moriyasujapan/mz32-fan-control/esp32/board.png

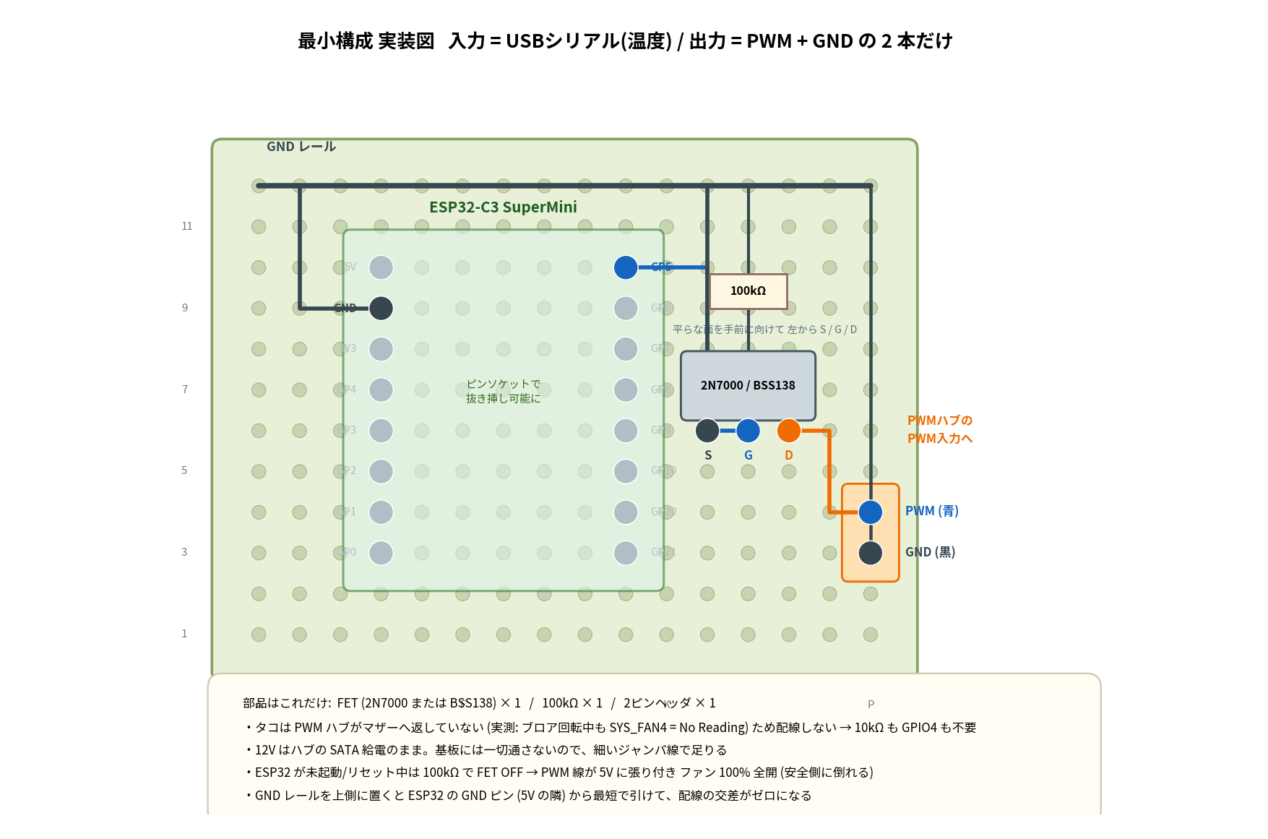
esp32/board.png
