moriyasujapan/mz32-fan-control/esp32/case_tnf2944_base.png

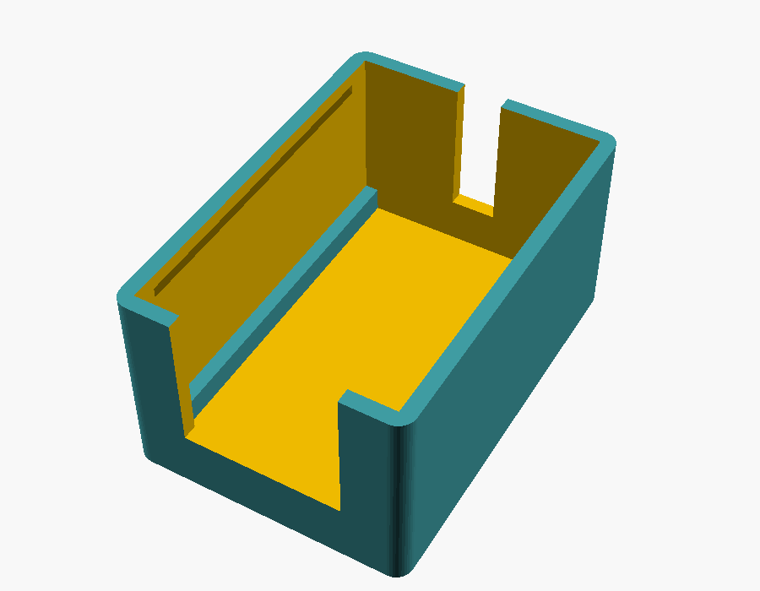
esp32/case_tnf2944_base.png
