moriyasujapan/mz32-fan-control/report.png

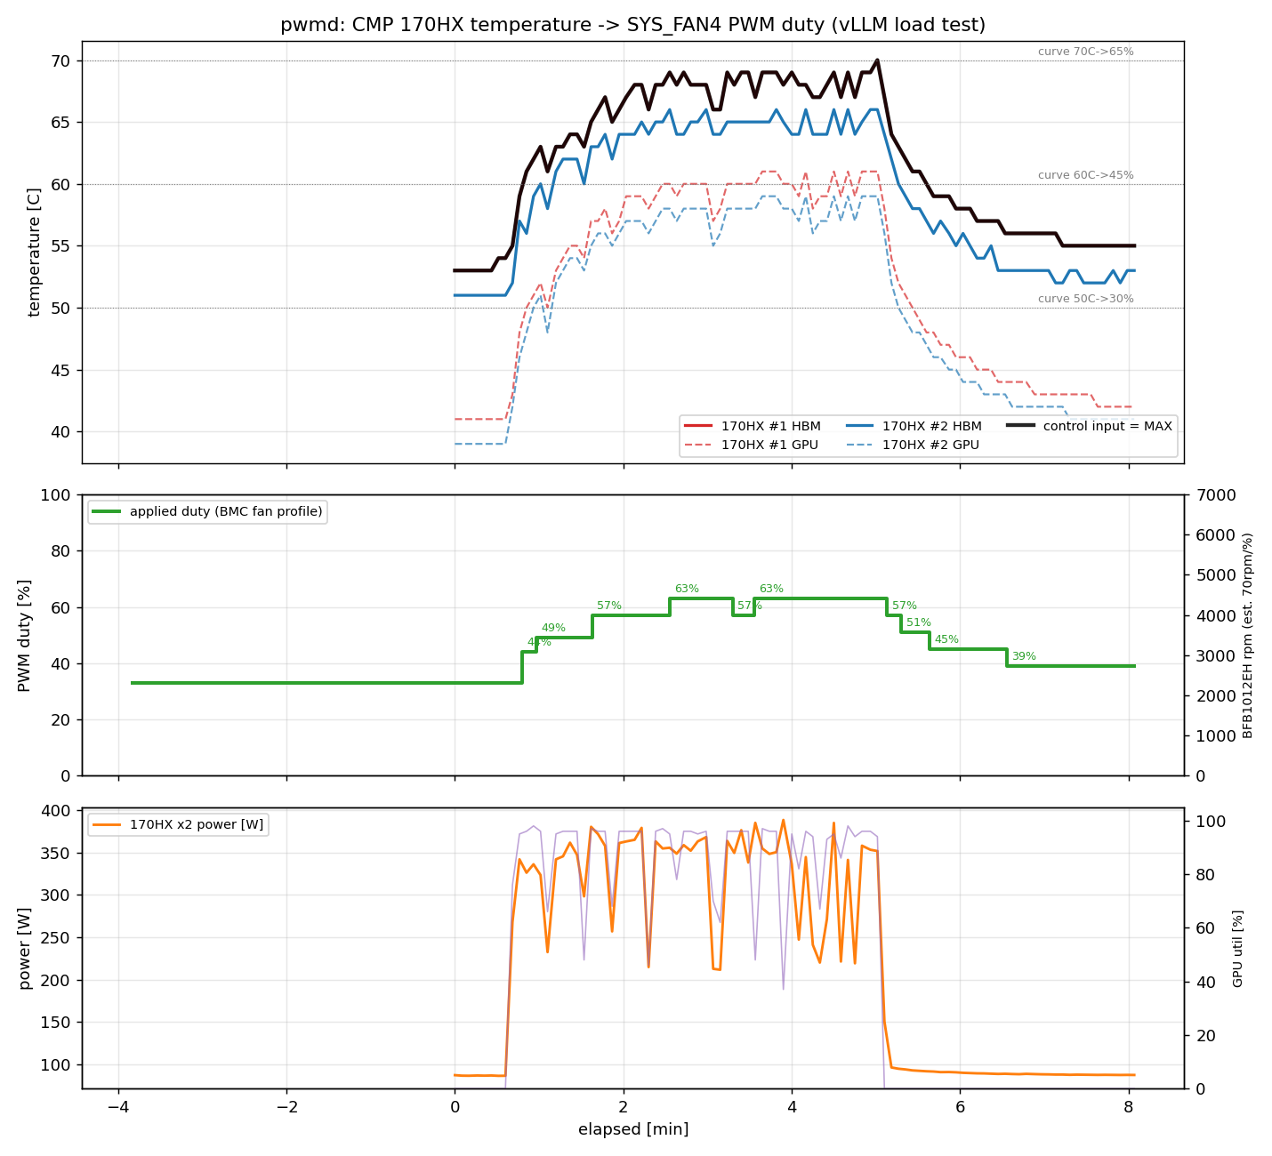
report.png
