moriyasujapan/mz32-fan-control/esp32/BOM.md

# M5Stamp-C3 ブロアファンコントローラ 部品表・配線表

対象ファン: **BitWindow BFB1012EH** (12V / 2.94A ≒ 35W / 7000rpm / 4PIN PWM)
マイコン: **M5Stack Stamp-C3 (SKU: C056-B)** — ESP32-C3 / 4MB Flash / USB-C (CH9102 経由) / 5V→3.3V DC-DC 内蔵
配線図: [wiring.png](wiring.png) ([wiring.svg](wiring.svg) が原本) / 実装図: [assembly_guide.png](assembly_guide.png)

## 0. SuperMini 版からの変更点

| 項目 | SuperMini 版 | Stamp-C3 版 |
|---|---|---|
| USB | native USB-CDC (GPIO18/19) | **CH9102 USB-UART ブリッジ** (UART0 = GPIO20/21) |
| Arduino 設定 | USB CDC On Boot: **Enabled** | USB CDC On Boot: **Disabled** (`Serial` は UART0 → CH9102) |
| 状態表示 LED | GPIO8 単色 LED | **GPIO2 SK6812 (RGB)** |
| ユーザーボタン | なし | **GPIO3** (外部ピン非露出) |
| 外部 IO | 0,1,3,4,5,6,7,10 他 | **G0,1,4,5,6,7,8,9,10,18,19,20,21** の 13 本 |
| 技適 | 無し (要 XIAO 等) | 取得済み |
| 実装 | 2×8 ピンソケット | 2.54mm ピッチ端子 (ピンヘッダを自分ではんだ付け) |
| PWM ピン | GPIO5 | **GPIO5 (変更なし)** |

## 0. 対応ボード

| ボード | PWM ピン | USB CDC On Boot | Arduino core | 状態LED | 技適 |
|---|---|---|---|---|---|
| **M5Stamp-C3** | **G5** (GPIO5) | **Disabled** (CH9102 → UART0) | 2.x / 3.x | SK6812 (G2) 青=boot/緑=host/赤=failsafe | あり |
| **XIAO ESP32C6** | **D1** (GPIO1) | **Enabled** (native USB Serial/JTAG) | **3.0.0 以降が必須** | 単色LED (GPIO15) 点灯=全開中 | 本体の刻印で要確認 |

ファームは `ARDUINO_XIAO_ESP32C6` の定義有無で自動的に切り替わる (v1.3.0〜)。
`V` コマンドの応答に `board=` が付くので、焼いたファームがどちらの設定か確認できる。

### XIAO ESP32C6 でピンを選ぶときの注意

ESP32-C6 のストラッピングピンは **GPIO4 / 5 / 8 / 9 / 15**。Stamp-C3 で使っていた
**GPIO5 は C6 では使用不可** (JTAG MTDI 兼ストラッピング、しかもヘッダに出ていない)。

XIAO C6 のヘッダは以下で、**いずれもストラッピングではない**ので自由に選べる:

| XIAO | D0 | D1 | D2 | D3 | D4 | D5 | D6 | D7 | D8 | D9 | D10 |
|---|---|---|---|---|---|---|---|---|---|---|---|
| GPIO | 0 | **1** | 2 | 21 | 22 | 23 | 16 | 17 | 19 | 20 | 18 |
| 備考 | ADC | **PWM 出力に使用** | ADC | | SDA | SCL | TX | RX | SCK | MISO | MOSI |

D0 (GPIO0) は将来サーミスタを足すとき用の ADC として空けてある。
D6/D7 は UART なので避ける。GPIO3 (RF スイッチ電源) と GPIO14 (アンテナ切替) は
ヘッダに出ていないが、外部アンテナを使う場合のみ触る。

出典: [Seeed Studio XIAO ESP32C6 Wiki](https://wiki.seeedstudio.com/xiao_esp32c6_getting_started/)

## 1. 部品表 (必須)

| # | 部品 | 型番・仕様 | 数量 | 価格目安 | 入手先 |
|---|---|---|---|---|---|
| 1 | マイコンボード | **M5Stack Stamp-C3 (C056-B)** または **Seeed XIAO ESP32C6** | 1 (予備込み2) | 1,000〜1,500円 | スイッチサイエンス / 秋月 / M5Stack公式 |
| 2 | Nch MOSFET | **2N7000** (TO-92) | 1 | 20円 | 秋月・共立 |
| 3 | 抵抗 | **100kΩ** 1/4W (ゲートプルダウン) | 1 | 5円 | 共立 6AZ312 |
| 4 | スズメッキ線 | **0.65mm** (裏面配線用・約15cm) | 1 | 手持ち | 秋月・共立 |
| 5 | 出力端子 | 2.54mm 2P ピンヘッダ (または 0.65mm 線を立てて端子に) | 1 | 10円 | 秋月・共立 |
| 6 | ケース兼基板 | PETG 印刷 (`stampc3_base` / `stampc3_lid` / `stampc3_bottom`) | 1式 | 材料費 約30円 | Bambu Lab A1 mini |
| 7 | 4PIN分岐ケーブル | 手持ちの PWM ハブ用分岐ケーブルを流用 | - | 0円 | - |
| 8 | USB ケーブル | USB-A ⇔ USB-C (データ通信対応) | 1 | 手持ち | - |

**合計 約1,100〜1,600円** (Stamp-C3 以外は 70 円程度)

ユニバーサル基板・変換基板・1kΩ ゲート抵抗は使わない。

## 3. MOSFET 選定の根拠

PWM 線のシンク電流は最大 5mA。2N7000 (Vgs(th) 最大 3V) を 3.3V で駆動するとオン抵抗は悪化するが、`5mA × 50Ω = 0.25V` で VIL(max) 0.8V に対し十分余裕がある。

## 4. 配線表

### Stamp-C3 側

| Stamp-C3 ピン | 接続先 | 備考 |
|---|---|---|
| **G5** (左列 3番) | FET ゲート (100kΩ で GND へプルダウン) | 25kHz PWM 出力 (LEDC) |
| GND (左列 1番) | FET ソース / 出力 GND / SATA の GND と共通 | **必須** |
| USB-C | ホストPCへ | 給電 + シリアル (CH9102)。入力は 5V のみ |
| 5V / 3V3 | 未接続 | 5V 端子と USB を同時に給電しない |

出力は **PWM と GND の 2 本のみ**。PWM ハブの「マザーへ挿す側の 4PIN オスプラグ」の **pin4 (PWM, 青)** と **pin1 (GND, 黒)** を使う。12V (pin2) と Tach (pin3) は触らない。

#### Stamp-C3 で使ってはいけないピン

| ピン | 理由 |
|---|---|
| **G20 / G21** | UART0 TX/RX。CH9102 に接続済みでシリアル通信に使用中 |
| **G8 / G9** | ストラッピングピン。G8 は書き込み時 High 必須 (プルダウン厳禁)、G9 は Low で書き込みモード |
| G2 | オンボード SK6812 (かつストラッピング)。外部非露出 |
| G3 | オンボードユーザーボタン。外部非露出 |
| G18 / G19 | native USB D-/D+。USB は CH9102 側なので GPIO として使えるが、起動直後に USB-JTAG 機能が有効なため PWM 用途には避ける |

→ 空いている **G0, G1, G4, G5, G6, G7, G10** から選ぶ。本設計では PWM=**G5**。

### ファン 4PIN コネクタ側

| Pin | 名称 | 線色 | 接続先 |
|---|---|---|---|
| 1 | GND | 黒 | SATA の GND (Stamp-C3 の GND と共通) |
| 2 | +12V | 赤 | SATA の +12V (黄) |
| 3 | Tach | 黄/緑 | **未接続** (PWM ハブがタコを返さないため) |
| 4 | PWM | 青 | FET ドレイン |

### FET (2N7000 / TO-92)

| 端子 | 接続先 |
|---|---|
| S (ソース) | GND |
| G (ゲート) | Stamp-C3 **G5** + 100kΩ → GND |
| D (ドレイン) | 出力 PWM → ハブ pin4 (青) |

## 4.5 ケース (PETG / Bambu Lab A1 mini)

> **重要 — 「ベース板が基板を兼ねる」方式は失敗した (2026-10-22 実機)**
>
> 当初は PETG のベース板に直接部品を挿し、裏面の溝に 0.65mm スズメッキ線を
> はめてはんだ付けする設計だった。**これは原理的に成立しない。**
>
> | | 温度 |
> |---|---|
> | PETG のガラス転移点 | **約 80℃** |
> | はんだごて | 300〜350℃ |
> | 共晶はんだの融点 | 183℃ |
>
> 部品のリードは金属なので、こて先の熱がそのまま穴の周囲へ伝わる。ランドの
> ない樹脂板では穴が広がって保持力を失う。印刷設定では解決せず、ABS/PC/ASA
> に変えても同じ (はんだ付け温度に耐える熱可塑性樹脂は実用範囲にない)。
> 基板が FR-4 (ガラスエポキシ、耐熱 130℃以上) である理由がこれ。
>
> また 0.65mm の裸スズメッキ線は熱容量が大きく、溝に置くだけでは固定もされず、
> 非常にはんだ付けしにくい。
>
> **対策: 回路はユニバーサル基板に組み、印刷物はケースとしてのみ使う。**
> 配線材は 0.65mm 裸線ではなく **ジュンフロン線 AWG30 (PTFE 被覆)** を推奨。
> こてが触れても被覆が縮まず、細くて取り回しが効き、交差させても短絡しない。
> 配線が 3 本しかないので、100kΩ の切り落とした足を流用するのも確実。

配線図: [assembly_guide.png](assembly_guide.png) (左: 下から見た裏面配線 / 右: 上から見た部品配置)
※ この図は破棄した「基板兼ケース」方式のもの。ユニバーサル基板版に引き直す必要がある。

| ファイル | 内容 | 印刷向き |
|---|---|---|
| `stampc3_base.stl` | 基板兼ベース (板厚 2mm + 下側スカート 4mm)。穴・裏面溝・刻印付き | 出力済みの向きのまま (板の上面がベッド側) |
| `stampc3_lid.stl` | 蓋。Stamp 上の窓、USB-C 開口、出力端子穴、ベースとのスナップ溝 | 出力済みの向きのまま (天面がベッド側) |
| `stampc3_bottom.stl` | 底蓋。Stamp 直下に LED 用の窓 | そのまま |

推奨設定: PETG / 0.4mm ノズル / 0.2mm レイヤー / 壁 3 周 / インフィル 25% / サポート不要。穴は 1.25mm (ヘッダ・出力) と 1.0mm (2N7000・抵抗)。きつい場合は 1.2mm ドリルで通す。

### 部品配置 (上から見た図)

- Stamp-C3: **付属ヘッダをピン下向き**ではんだ付けし、22 穴に挿す。USB-C は G0/G1 側の端で、蓋の開口に合わせる
- **状態 LED は下向き**。ベース板と底蓋の Stamp 直下を抜いてあり、下から見える
- 2N7000: Stamp 左列から 4 ピッチ左。**平らな面を外側 (Stamp と反対) に向け**、上から S / G / D
- 100kΩ: Stamp 左列から 2 ピッチ左に縦に寝かせる。リードの間隔は 10.16mm
- 出力 2P: 一番左。上が GND、下が PWM。ピンヘッダか、0.65mm 線を立てて端子にする

### 裏面配線 (0.65mm スズメッキ線を溝にはめる)

| 線 | 経路 | 
|---|---|
| GND | Stamp GND (左列1番) → 100kΩ 上端 → 2N7000 S → 出力 GND (一直線) |
| GATE | Stamp G5 (左列3番) → 下へ → 100kΩ 下端 → 上へ → 2N7000 G |
| PWM | 2N7000 D → 出力 PWM |

各経路と別ネットの穴とは最小 2.54mm 離してある。裏面には `G5 / GND / PWM / 2N7000 / USB` を下から見て読める向きで刻印してある。Stamp のその他 20 ピンは機械的固定のみで配線しない。ヘッダの突き出しは 1.5mm 程度に切る。

### 組み立て順

1. 2N7000 と 100kΩ を表から挿し、裏で足を溝に沿わせて仮止め
2. 0.65mm 線を 3 本切り、溝にはめて各穴ではんだ。余った足は切る
3. 出力 2P を挿してはんだ
4. ヘッダ付き Stamp-C3 を挿してはんだ (G5 と GND は線と一緒に、残りは固定用)
5. テスターで G5–GND 間が約 100kΩ、GND–PWM 間が開放であることを確認
6. ベースを下から蓋に押し込みスナップ。底蓋を押し込む

## 4.6 代替案: BSS138 レベル変換モジュール

単石 FET の代わりに [秋月 AE-LCNV4-MOSFET](https://akizukidenshi.com/catalog/g/g113837/)
(4ビット双方向ロジックレベル変換、BSS138、¥200、DIP12) を使える。DIP モジュール
なのでユニバーサル基板に素直に載り、**100kΩ が不要になる** (LV 側に 10kΩ
プルアップ内蔵、ゲートは内部で LV に接続)。

| モジュール | 接続先 |
|---|---|
| `LV` | Stamp **3V3** |
| `GND` | Stamp **GND** |
| `LV1` | Stamp **G5** |
| `HV1` | ハブ **pin4 (PWM 青)** |
| `HV` | **未接続** |

**`HV` を繋がないこと。** ファンが自前で 5V プルアップを持つので不要。Stamp の
5V を引くと、USB を抜いたときにモジュール側の 10kΩ が PWM 線を引き下げて分圧に
なる。未接続ならファンのプルアップが素直に勝って全開へ倒れる。

**外付けの 100kΩ プルダウンは付けない。** G5 がハイインピーダンス (起動中・
電源断) のとき、モジュール内蔵の LV プルアップが MOSFET を OFF にする。

### 論理が反転しなくなる

このモジュールは**非反転**なので、ファームの `PWM_INVERT` を `false` にして
書き込み直す必要がある。

| | 単石 FET | BSS138 モジュール |
|---|---|---|
| `PWM_INVERT` | `true` | **`false`** |
| G5 HIGH のとき PWM 線 | LOW | **HIGH** |
| 部品 | 2N7000 + 100kΩ | モジュールのみ |
| 配線 | 3 本 | 4 本 |

どちらの構成でも `duty=100` は「ファン全開」を意味し、boot / failsafe /
電源断のいずれでも全開に倒れる。`VER` 応答の `invert=` で現物がどちらで
ビルドされたか確認できる。

**PCA9306 (AE-PCA9306) は使わないこと。** I2C 専用のパスゲートで、1kΩ の強い
プルアップを内蔵している。VREF2 を Stamp の 5V から取ると、電源断時に PWM 線を
0.8V 程度まで引き下げてしまい、「電源断 = 全開」の安全性が逆転する。

## 5. 組み立て前に確認すること

1. **ファンの PWM プルアップ電圧をテスターで測る** (5V なら本設計どおり)。
2. **GND が共通になっているか**。Stamp-C3 をホストの USB から給電すればホスト PSU 経由で SATA の GND と共通になる。別の AC アダプタから給電しない。
3. **FET 無しで直結しない**。5V プルアップのファンに ESP32-C3 (絶対最大定格 3.6V) を直結すると破損する。
4. **USB ドライバ**: Linux は標準ドライバで `/dev/ttyACM0` (環境により `/dev/ttyUSB0`) として見える。macOS/Windows は CH9102 ドライバを導入。

## 6. ファームウェアの要点

SuperMini 版から変更するのは以下だけ。

- PWM: **LEDC 25kHz / 10bit**。`PWM_INVERT = true` なら `duty_out = 1023 - duty_target`、
  `false` なら `duty_out = duty_target` (出力段の方式に合わせる)
- `PIN_PWM = 5` (変更なし)
- 状態 LED を SK6812 (G2) に変更 (実装済み): arduino-esp32 v3 は `rgbLedWrite(2, r, g, b)`、
  v2 系は `neopixelWrite`。ファーム側で `ESP_ARDUINO_VERSION_MAJOR` を見て自動で切り替える
  - **boot=青 / host 制御=緑 / failsafe=赤**
- フェイルセーフ・シリアルプロトコルは変更なし (ファーム `1.1.0`)

### 書き込み手順 (Arduino IDE)

1. ボードマネージャで **esp32 by Espressif Systems** を入れる
2. ボード: **ESP32C3 Dev Module** (または M5Stack ボードパッケージの **M5StampC3**)
3. **USB CDC On Boot: Disabled** (Enabled にすると `Serial` が native USB に向き、CH9102 側に何も出ない)
4. 書き込みは CH9102 の DTR/RTS による自動リセットで入る。失敗する場合は G9 を GND に落としたままリセット
5. `screen /dev/ttyACM0 115200` などで `P` を送り `PONG pwmfan 1.2.0` が返れば成功

### ホスト側 (pwmd.py) の注意

CH9102 の DTR/RTS は ESP32-C3 の EN / G9 に繋がっているため、ポートを開くと**リセットが掛かる**。

**実測 (2026-10-22 / Ubuntu 26.04 + cdc_acm)**: `dtr=False` / `rts=False` を open 前に
セットしても、`stty -hupcl` を併用しても**リセットは防げない**。cdc_acm が open 時に
一度 DTR を上げるため。open のたびに `rst:0x1 (POWERON)` が起き、ROM ブートログが
9 行 (236 bytes) 流れてくる:

```
ESP-ROM:esp32c3-api1-20210207
rst:0x1 (POWERON),boot:0xc (SPI_FAST_FLASH_BOOT)
... entry 0x403cbf10
```

リセット自体は**安全側**なので許容する (boot = 100% 全開 / LED 青)。ただし
**ブートログを応答と取り違えると `set_duty` が失敗 → 再オープン → 再リセットの
ループに陥る**ため、ホスト側で読み捨てが必須。[`pwmd.py`](../pwmd.py) の
`SerialBackend` は `_drain()` でブートログを捨て、`OK / ST / PONG / VER / ERR`
で始まる行だけを応答として受け付ける (回帰テスト `[6]`)。

シェルから叩くときは、ディスクリプタを開きっぱなしにすれば追加のリセットは起きない:

```bash
sudo bash -c '
exec 3<>/dev/ttyACM0
stty -F /dev/ttyACM0 115200 raw -echo
timeout 1.5 cat <&3 >/dev/null     # ブートログを捨てる
echo "P" >&3; read -t 2 -r l <&3; echo "$l"
'
```

pyserial で開く場合はこの形 (DTR/RTS を落とすこと自体は他のアダプタで効くので残す):

```python
ser = serial.Serial()
ser.port = "/dev/ttyACM0"
ser.baudrate = 115200
ser.dtr = False
ser.rts = False
ser.open()
```

## 7. 現行 (BMC Web API) 版との関係

SuperMini 版と同じ。マザーボードの SYSFAN ヘッダーは使わず BMC から独立。Stamp-C3 が故障したら PWM 線を SYS_FAN4 に差し替えるだけで BMC 版へ戻せる。

## 7.5 組み立て時の落とし穴: 極性が反転する配線ミス (2026-10-22 実機で遭遇・解決済み)

**症状**: `D 20` でファンが高速、`D 100` でほぼ停止。つまり **ファン速度 = 100 - duty**。
FET によるオープンドレイン反転が効かず、G5 の信号がそのまま PWM 線に出ている。

**原因**: 出力 PWM を FET の**ドレインではない端子**から取っていた。TO-92 の
真ん中はゲートで、ここから取ると FET を素通りして G5 が直接ファンの PWM 線を
駆動する。ドレインとソースを逆に挿しても同様に正しく動かない。

**切り分け** (SYS_FAN4 を抜いて単独駆動にしてから行うこと。繋いだままだと
BMC のプッシュプル出力と競合し、音も温度も判定材料にならない):

| 試験 | 正しい配線なら | 反転しているなら |
|---|---|---|
| `D 100` | **全開** | ほぼ停止 |
| `D 20` | 静か | うるさい |
| デーモン停止 (30秒無通信 → failsafe) | **全開** | 静かなまま温度上昇 |

`D 50` はどちらの極性でも 50% になるので、切り分け中の暫定保持に使える。

**最も確実な判定**: デーモンを止めて全開になるかを聴く。これは同時に
「ホストが死んでも冷え続ける」という設計の核心を検証することにもなる。

**配線の正解** (ノードは 3 つだけ):

| ノード | 繋がるもの |
|---|---|
| ゲート | `G5` ＋ 100kΩ の片脚 ＋ FET の **G**（真ん中） |
| GND | `GND` ＋ 100kΩ のもう片脚 ＋ FET の **S** ＋ ハブ pin1 |
| PWM | FET の **D** ＋ ハブ pin4（青） |

GND はゲートに直結しない。100kΩ はゲートノードと GND ノードを橋渡しする部品で、
G5 が出力していない間ゲートを 0V に保つ (→ FET OFF → PWM 線 5V → 全開)。

**真の S / D をテスターで見分ける** (ダイオードモード。平らな面の向きに頼らない):

- 赤 **S** / 黒 **D** → 0.6〜0.7V（ボディダイオードが順方向）
- 赤 **D** / 黒 **S** → OL（開放）
- **G** はどちらに対しても OL

**放置してはいけない理由**: ゲート側から PWM を取っていると、G5 がファン内部の
5V プルアップに直結する。ESP32-C3 の絶対最大定格 3.6V を超え、クランプ
ダイオードに `(5 - 3.6) / 3.3k ≈ 0.4mA` が流れ続ける。正しくドレインから
取れば GPIO が 5V に触れることはない。

**応急処置** (配線を直すまでの繋ぎ): `config.ini` に `[serial] invert = true`。
ホスト側が `100-duty` を送る。ただしこれは**通常運転しか直せない**。ファームの
failsafe (duty=100) と電源断時の安全性は反転したままで、どちらも「全開」ではなく
「停止」を意味する状態が残る。必ず配線を直して `invert = false` に戻すこと。

## 8. ファームウェア

| ファイル | 内容 |
|---|---|
| [`pwmfan/pwmfan.ino`](pwmfan/pwmfan.ino) | Stamp-C3 用ファーム (Arduino) `1.2.0`。25kHz LEDC + `PWM_INVERT` + 30秒フェイルセーフ + 状態 LED |
| [`mock_pwmfan.py`](mock_pwmfan.py) | 同じプロトコルを pty 上で再現するモック。実機なしで検証するため |
| [`test_serial_backend.py`](test_serial_backend.py) | `pwmd.py` の serial バックエンド結合テスト (15項目) |

### シリアルプロトコル

| 送信 | 応答 | 意味 |
|---|---|---|
| `D <0-100>` | `OK D=<n>` | duty 設定 (このコマンドがフェイルセーフのタイマもリセットする) |
| `S` | `ST duty=<n> src=<host\|failsafe\|boot> age=<ms>` | 状態取得 |
| `P` | `PONG pwmfan <ver>` | 疎通確認 |
| `V` | `VER pwmfan <ver> pin=<n> freq=<hz> invert=<0\|1>` | ビルド情報。`invert` で出力段の論理を確認できる |
| - | `EV failsafe timeout -> 100%` | 非同期通知 (ホスト沈黙時)。boot 中は出さない |

### 状態 LED (G2 / SK6812)

| 色 | 状態 | duty |
|---|---|---|
| 青 | boot — ホストとまだ一度も喋っていない | 100% |
| 緑 | host — ホストの指示どおり制御中 | 指示値 |
| 赤 | failsafe — ホストが 30 秒沈黙した | 100% |

### 検証結果 (モックファーム / 2026-10-22)

```
[1] 初期化      V/P 応答、起動直後は boot=100% (安全側)
[2] duty 指示   D 63 反映、S で確認、小数は四捨五入
[3] Controller  ヒステリシス内は据え置き + heartbeat は送出
[4] フェイルセーフ 無通信で 100%、再開で host 制御へ復帰
[5] 障害復旧    ポート切断後に自動再オープンして送信成功
[6] ブートログ  リセット直後の ROM ログを応答と誤読しない
→ 15 項目すべて PASS
```
