moriyasujapan/mz32-fan-control/esp32/case_tnf2944_base.stl

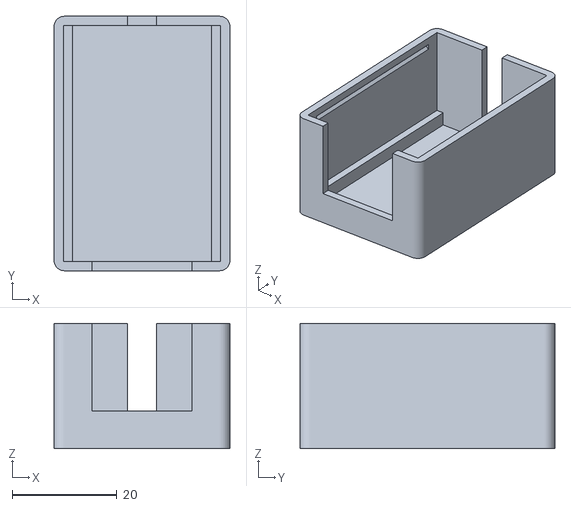
[picture p7: CAD file, 2026-10-25]
esp32/case_tnf2944_base.stl
33.6 x 48.6 x 23.9
