moriyasujapan/mz32-fan-control/esp32/case_tnf2944_lid.stl

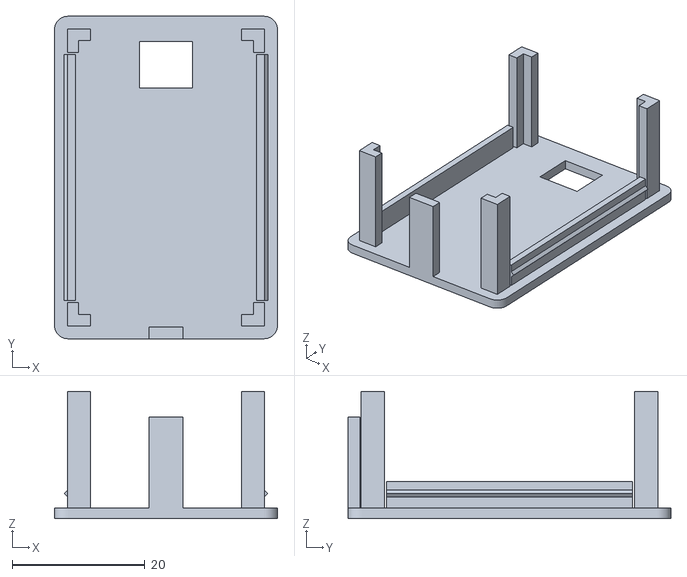
[picture p8: CAD file, 2026-10-25]
esp32/case_tnf2944_lid.stl
33.6 x 48.6 x 19.2
