moriyasujapan/mz32-fan-control/esp32/case_tnf2944.3mf

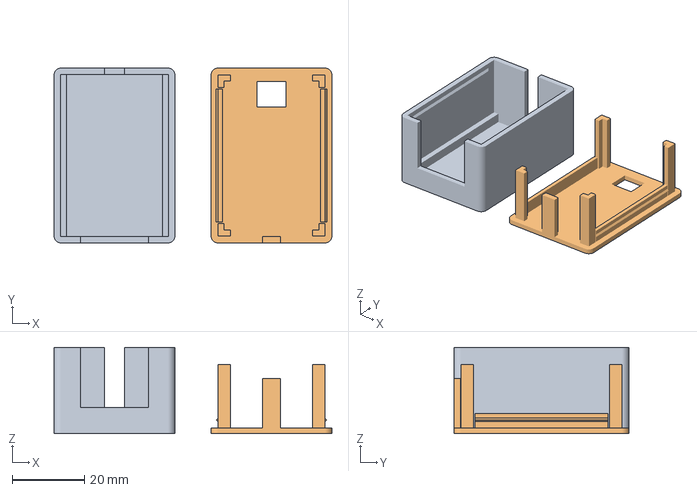
[picture p9: CAD file, 2026-10-25]
esp32/case_tnf2944.3mf
77.2 x 48.6 x 23.9 mm
case_tnf2944_base
case_tnf2944_lid
