moriyasujapan/mz32-fan-control/esp32/stampc3_lid.stl

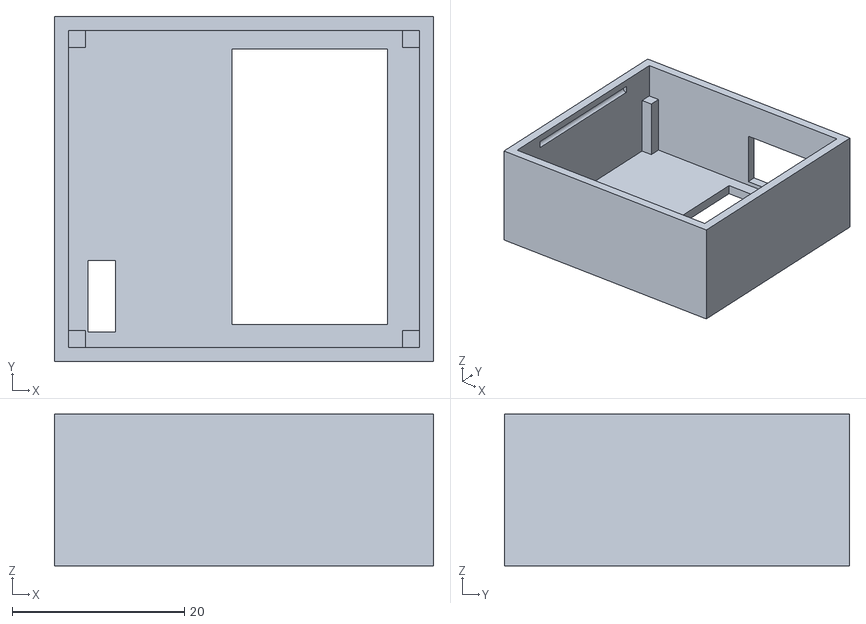
[picture p10: CAD file, 2026-10-21]
esp32/stampc3_lid.stl
44.0 x 40.0 x 17.6
