moriyasujapan/mz32-fan-control/esp32/stampc3_base.stl

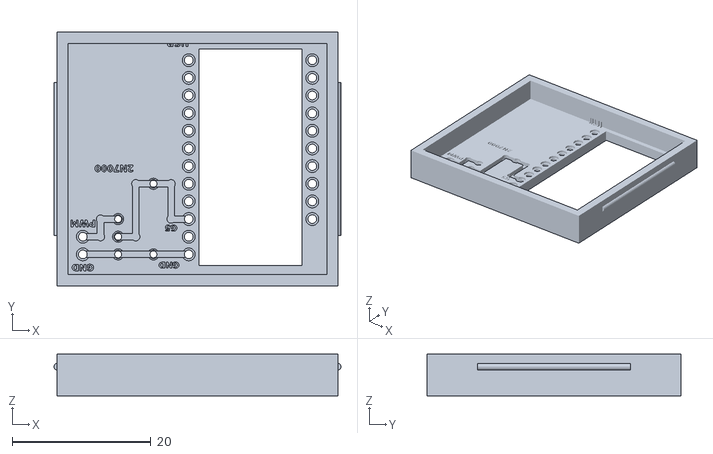
[picture p11: CAD file, 2026-10-21]
esp32/stampc3_base.stl
41.3 x 36.5 x 6.00
