moriyasujapan/mz32-fan-control/esp32/stampc3_bottom.stl

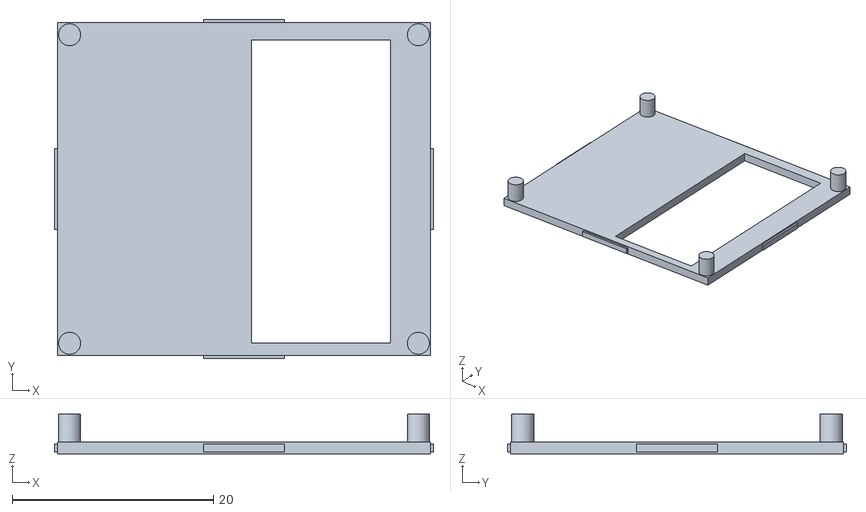
[picture p12: CAD file, 2026-10-21]
esp32/stampc3_bottom.stl
37.7 x 33.7 x 3.95
