moriyasujapan/mz32-fan-control/esp32/assembly_guide.png

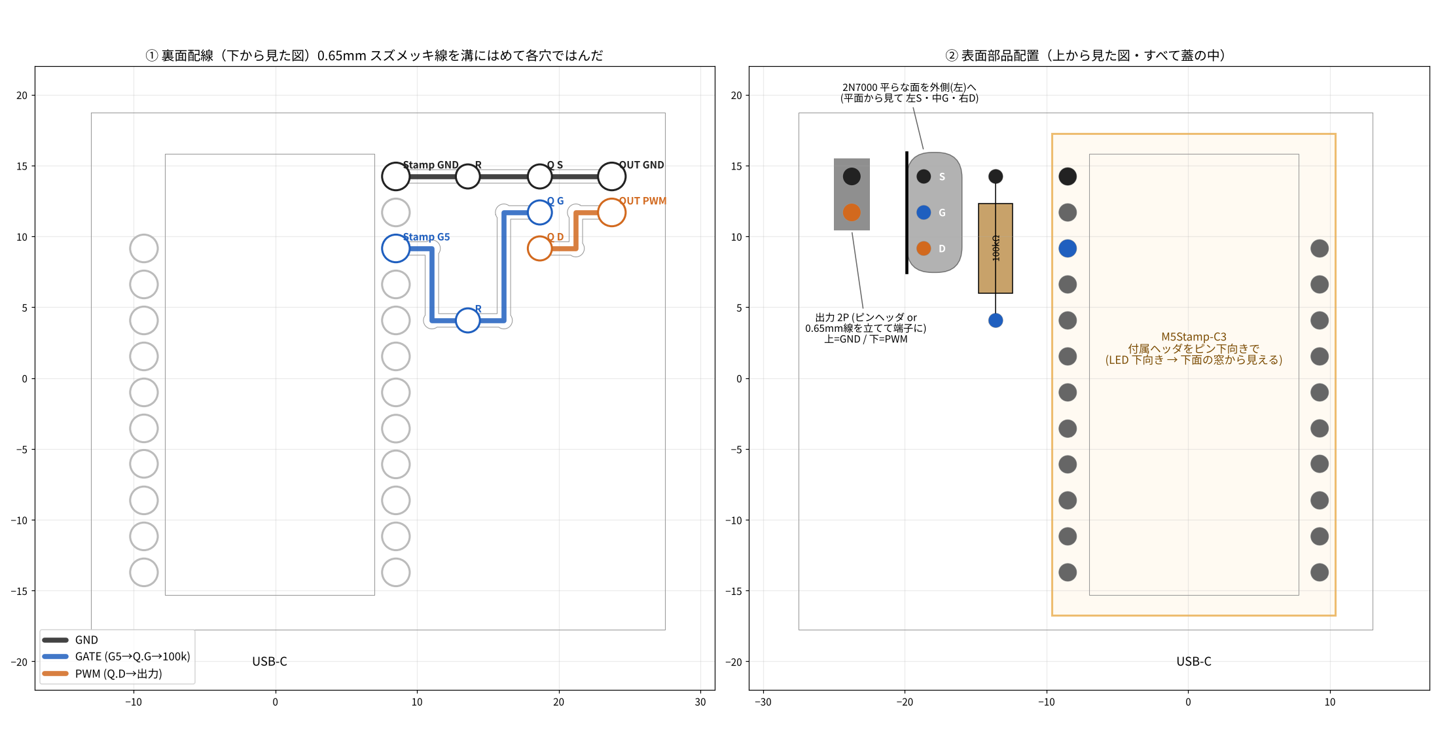
esp32/assembly_guide.png
