moriyasujapan/mz32-fan-control/esp32/wiring.png

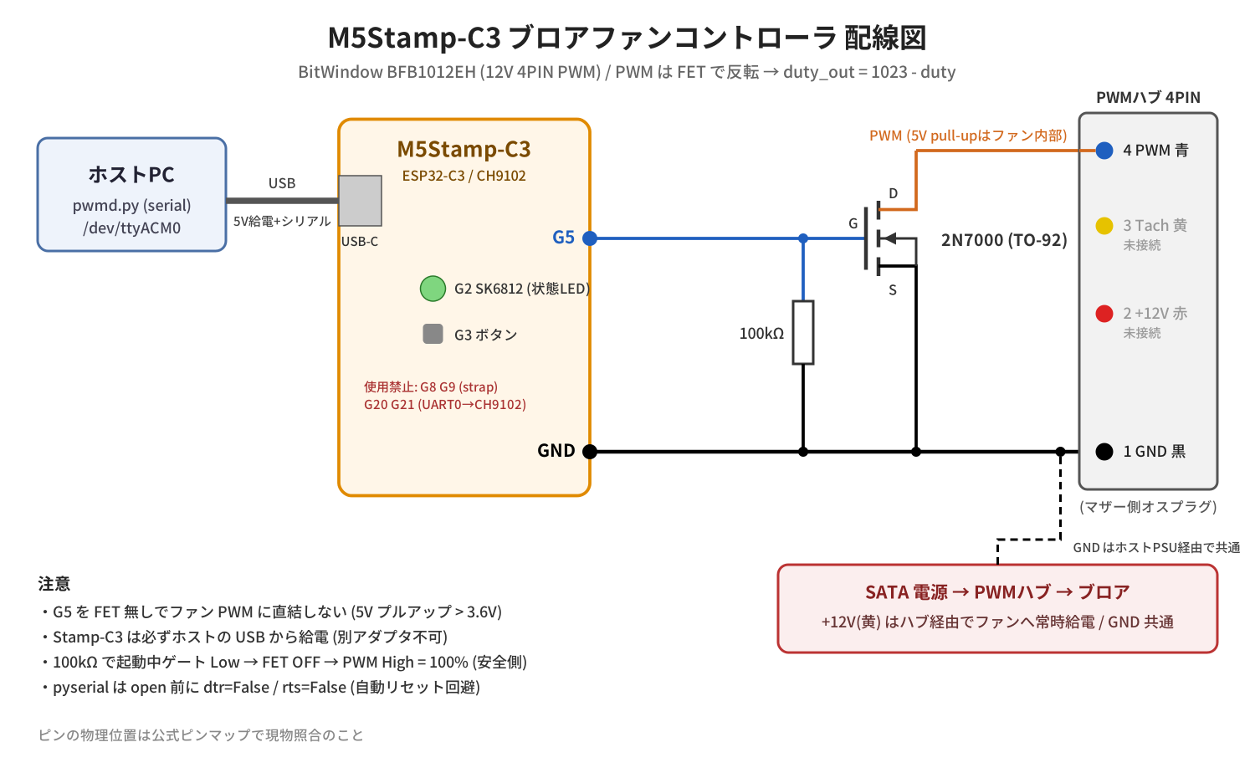
esp32/wiring.png
