moriyasujapan/mz32-fan-control/config.example.ini

; pwmd 設定ファイルのサンプル。
; config.ini としてコピーし、環境に合わせて書き換えてください。
;   cp config.example.ini config.ini && chmod 600 config.ini
; config.ini は .gitignore 済み (BMC の認証情報を含むため)

[bmc]
host = 192.168.0.100
user = admin
password = CHANGE_ME
verify_tls = false

[fan]
; 出力先: bmc = BMC Web API の Fan Profile (MZ32-AR0 の唯一のIPMI外経路)
;         serial = ESP32 (esp32/pwmfan/pwmfan.ino) へ USB シリアルで duty 送信
backend = bmc

; 配線したSYSFANヘッダーのセンサー番号:
;   184=CPU0_FAN 186=SYS_FAN1 187=SYS_FAN2 188=SYS_FAN3 189=SYS_FAN4
; ※SYS_FAN5(190)はプロファイル対象外でPWMフル固定・制御不可(実測)
sensor = 189

[gpu]
; 温度ソース: 対象GPUのPCI bus id (複数枚ならMAXを使用)
pci_ids = 41:00.0, 42:00.0
; HBM温度 (temperature.memory) も max に含める
; CMP 170HX では HBM が GPU コアより +9〜11℃ 高い実測値のため true 推奨
include_hbm = true
; この温度を超えたらカーブを無視して即100%
emergency_temp = 90

[curve]
; 温度MAX(℃) -> PWM duty% 。; 区切り、線形補間
; 非対称追従: 上昇は即応、下降は律速してハンチングを抑える
; fall_rate  : 制御用の基準温度を 1 分あたり何℃まで下げてよいか (0 で無効)
; fall_offset: 下降局面でカーブを何℃高温側にずらすか (デッドバンド)
fall_rate = 4
fall_offset = 0
table = 35:20; 50:30; 60:45; 70:65; 75:80; 80:92; 85:100

[daemon]
profile_name = pwmd
poll_interval = 5
; duty変更の最小単位% (ヒステリシス。API書き込み削減)
min_duty_step = 10
; 常時最低duty (ファン停止防止)。実機で失速点を測って +5% 程度に
min_duty = 20
max_duty = 100
; nvidia-smi がこの回数連続失敗したら 100% 全開にする
sensor_error_cycles_for_full = 12
; 制御ループがこの秒数止まったらプロセス自殺→systemdが再起動 (ハング対策)
watchdog_timeout = 60
; 終了時にBMCを純正モードへ戻すか。false=最後のdutyを維持して離脱(推奨)
restore_on_exit = false

[serial]
; backend = serial のときだけ使用
; ttyACM 番号は他の CDC 機器で変わるので、実機では by-id 名を推奨:
;   port = /dev/serial/by-id/usb-Espressif_USB_JTAG_serial_debug_unit_<MAC>-if00
; デバイスは root:dialout 0660。pwmdaemon.service の SupplementaryGroups=dialout で開ける。
port = /dev/ttyACM0
baud = 115200
timeout = 2.0
; 配線が非反転 (FETのオープンドレインを経由していない) 場合に true。
; 設計どおり FET で反転しているなら false のままにする。
; true にしてもファームの failsafe (無通信30秒 -> duty 100) は反転したままで、
; 非反転配線ではファン 0% を意味する。恒久対策はファーム修正か配線修正。
invert = false
