moriyasujapan/mz32-fan-control/(commit log)

2026-10-21 MZ32-AR0 + CMP 170HX のGPU温度連動ファン制御一式
    BMC Web API の Fan Profile を叩いて SYSFAN ヘッダーの PWM を制御する
    常駐デーモンと、BMC 非依存の ESP32 版への移行設計。
    - pwmd.py: nvidia-smi で max(GPU,HBM) を読み、カーブ補間した duty を
    BMC へライブ書き込み。3層の自動復帰 (例外リトライ / 内部ウォッチドッグ /
    systemd WatchdogSec) を実装し、いずれも実機試験済み
    - IPMI OEM 全 netfn 走査、PCIe P2A・LPC iLPC2AHB の調査結果を README に記録
    - vLLM 負荷試験のグラフ生成スクリプトと実測結果
    - esp32/: 配線図・基板実装図・部品表
2026-10-21 ESP32バックエンドを実装 (BMC非依存の出力経路)
    - esp32/pwmfan/pwmfan.ino: ESP32-C3 用ファーム。LEDC 25kHz、FETの論理反転を
    吸収、30秒無通信で100%へ倒れるハードウェアフェイルセーフ付き
    - pwmd.py: 出力をバックエンド抽象へ分離し [fan] backend = bmc | serial で
    切替可能に。serial は毎サイクル duty を送って ESP32 のフェイルセーフを維持、
    ポート切断時は自動再オープン
    - esp32/mock_pwmfan.py + test_serial_backend.py: pty 上でファームを再現し、
    実機なしで結合テスト (13項目 PASS)
    - BMC バックエンドは実機で回帰確認済み (duty 68% 適用, status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
2026-10-21 feat: ESP32-C3 SuperMini から M5Stamp-C3 へ移行
    実機を M5Stamp-C3 (C056-B) で組んだため、ファーム・配線・筐体を差し替えた。
    ファーム (pwmfan.ino 1.0.0 -> 1.1.0)
    - USB CDC On Boot: Disabled 前提へ (Stamp-C3 の USB-C は CH9102 -> UART0)
    - arduino-esp32 2.x / 3.x の LEDC・RGB LED API 差分を #if で吸収
    - オンボード SK6812 (G2) で状態表示: 青=boot / 緑=host / 赤=failsafe
    - srcName() を修正。ホストと未通信の間は failsafe ではなく boot を返す
    ホスト (pwmd.py)
    - SerialBackend.open() で DTR/RTS を落としてから open。CH9102 の DTR/RTS は
    EN / GPIO9 に繋がっており、既定のまま開くと自動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
    [stampc3_base.stl, stampc3_bottom.stl, stampc3_lid.stl]
2026-10-21 fix: ポート open 時のリセットで流れる ROM ブートログを応答と誤読しない
    実機 (M5Stamp-C3 / Ubuntu 26.04 + cdc_acm) で検証したところ、ポートを開くと
    必ず rst:0x1 (POWERON) が起き、ROM ブートログが 9 行 236 bytes 流れてくる。
    open 前に DTR/RTS を落としても stty -hupcl を併用しても防げない (cdc_acm が
    open 時に一度 DTR を上げるため)。前のコミットのコメントはこの点が誤っていた。
    リセット自体は安全側 (boot = 100% 全開) なので許容する。問題はブートログの方で、
    command() が "EV " 以外のすべての行を応答として返していたため、set_dut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
    [mock_pwmfan.py, pwmd.py, test_serial_backend.py]
2026-10-21 feat: 非反転配線向けに [serial] invert オプションを追加
    実機 (M5Stamp-C3) で極性を測ったところ、設計と逆だった。SYS_FAN4 を抜いた
    単独駆動で以下を確認:
    D 20 -> ファンは高速 (うるさい)
    D 100 -> ファンはほぼ停止
    failsafe (無通信30秒 -> duty 100) でも静かなまま、GPU 温度が上昇
    つまり実際の対応は「ファン速度 = 100 - duty」で、FET によるオープンドレイン
    反転が効いていない。この状態でカーブをそのまま流すと、高温ほどファンが遅く
    なり GPU を焼く。
    - [serial] invert = true でホスト側が 100-duty を送るようにした (既定 fa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
    [config.example.ini, pwmd.py, test_serial_backend.py]
2026-10-21 docs: 極性反転の実機症状・切り分け手順・恒久対策を BOM に記録
2026-10-21 docs: 極性反転の原因と正しい配線・判定手順を確定版に更新
    実機で解決したため、未解決の既知問題から組み立て時の落とし穴として書き直した。
    - 原因はドレイン以外の端子から PWM を取っていたこと
    - ノード3つでの正しい配線と、テスターでの真の S/D 判定手順を追記
    - 最も確実な判定は「デーモンを止めて全開になるか」(failsafe の検証を兼ねる)
    - 切り分けは必ず SYS_FAN4 を抜いて単独駆動で行う旨を強調
    - invert=true はあくまで繋ぎで、failsafe と電源断時の安全性は直らない点を明記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
2026-10-21 revert: board.png と draw_board.py を復元
    ケース兼基板 (PETG 直はんだ) 方式が実機で破綻したため、ユニバーサル基板
    方式に戻す。その土台として SuperMini 版の実装図が有用なので復元する。
    PETG のガラス転移点は約 80℃ で、はんだごて 300〜350℃ の熱が部品リードを
    伝って穴の周囲に届くため、樹脂板への直はんだは原理的に成立しない。
    3ba78be で「現物と食い違う」として削除したが、配置の考え方 (GND レールを
    上端に通す / ピンソケットで抜き挿し可能にする / 出力は 2P ヘッダ) は
    Stamp-C3 でもそのまま使える。
    図その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
    [draw_board.py]
2026-10-21 feat: 出力段の論理を PWM_INVERT で切り替え可能にする (ファーム 1.2.0)
    BSS138 レベル変換モジュール (秋月 AE-LCNV4-MOSFET) を使う選択肢を加えた。
    このモジュールは非反転なので、単石 FET のオープンドレイン反転とは論理が逆。
    配線方式ごとにファームを書き分けずに済むよう、定数 1 つで吸収する。
    - PWM_INVERT を追加。既定 true = 現状の単石 2N7000 構成のまま (挙動不変)
    - VER 応答に invert=<0|1> を追加。現物がどちらでビルドされたか確認できる
    - true / false 両方で esp32:esp32:esp32c3 のコンパイルを確認 (ともに 23%)
    BOM:
    - 4.5 「ベ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
    [mock_pwmfan.py, pwmfan.ino]
2026-10-21 feat: 温度カーブに非対称追従 (上昇は即応・下降は律速) を追加
    負荷が切れた瞬間に duty を落とすと温度がすぐ戻り、85→77→82% のように
    往復して耳につく。下降方向だけ基準温度の低下速度を制限する。
    - [curve] fall_rate (既定12℃/min): 基準温度を1分あたり何℃まで下げてよいか
    - [curve] fall_offset (既定0℃): 下降局面のデッドバンド
    - 上昇方向は従来どおり即座に追従 (安全優先)
    - 下降中の duty は上昇局面の到達値を超えない clamp 付き
    - esp32/test_curve_hysteresis.py: 制御則のシミュレーション検証 (5項目PASS)
    実機: HBM 73〜77℃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
2026-10-22 tune: 実測に合わせて既定値を fall_rate=4 / min_duty_step=10 に変更
    HBM が ±4℃ 揺れる環境では fall_rate=12 でも 20 秒で 4℃ 分下がりきり、
    カーブの急勾配帯 (75-80℃ で 2.4%/℃) により 77↔82% の往復が残っていた。
    実機で 3 分間 duty 変更 0 回を確認した値を既定にする。
2026-10-23 feat: XIAO ESP32C6 対応 (ファーム 1.3.0 / ボード自動判別)
    ESP32-C6 のストラッピングピンは GPIO4/5/8/9/15 で、Stamp-C3 で使っていた
    GPIO5 は使用不可 (JTAG 兼ストラッピング、ヘッダ非露出)。XIAO C6 のヘッダ
    D0-D10 (GPIO 0,1,2,21,22,23,16,17,19,20,18) はいずれも非該当なので D1 を使う。
    - ARDUINO_XIAO_ESP32C6 の有無で PWM ピン・状態LED・ボード名を自動切替
    - V コマンドの応答に board= を追加し、焼いたファームの設定を確認可能に
    - arduino-cli (esp32 core 3.3.12) で両ボードのコンパイルを検証
    XIAO_ESP32C6 : 262648 bytes (20%)
    esp32c3 : 309454 bytes (23%)
    -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
2026-10-24 fix: serial backend をサービス権限と by-id ポートで常用できるようにする
    ESP の /dev/ttyACM* は root:dialout 0660 で、User=build のサービスは
    dialout に入っていないと開けない。手で付けた ACL は USB の抜き差しで消えるため、
    SupplementaryGroups=dialout でサービスのプロセスだけに付与する。
    2026-10-24 に ACL を外した状態でデーモンがポートを開けることを実機で確認した。
    ttyACM 番号は他の CDC 機器で変わるので、設定例に by-id 名での指定を追記した。
    [config.example.ini]
2026-10-24 docs: 現行の出力段を ESP serial に切り替え、負荷試験と切り替え時の注意を追記
    - README: ESP serial 版を現行とし、2026-10-24 の vLLM 負荷試験
    (16 並列 約5分、平衡 65〜69℃ / duty 61% / peak 391W) を report-serial.png 付きで記録。
    BMC 版の 69〜70℃ / 63% と同等以上に冷えている。
    - README: 切り替えで踏んだ点 (SYS_FAN4 を抜く、dialout、by-id、
    CDCOnBoot=cdc の明示、耳での極性・failsafe 確認、XIAO の LED の意味) を追記。
    - pwmfan.ino: arduino-esp32 3.3.12 の CDCOnBoot=default は Disabled の意味で、
    焼くと USB が無言になる旨とビルドコマンドをコメントに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
    [plot_report.py, pwmfan.ino]
2026-10-25 feat: TNF29-44 ユニバーサル基板用のケースと、印刷までの道具一式
    回路をユニバーサル基板に組んだので、印刷物はケースとしてのみ使う方針
    (BOM 4.5 節) に沿って、タカチ TNF29-44 (29x44x1.6mm) 用のケースを起こした。
    - esp32/case_tnf2944.scad: 寸法を変数で持つ OpenSCAD の元データ。外形は
    33.6 x 48.6 x 25.5mm。取付穴の無い基板なので、長辺の棚で受けて蓋の四隅の
    L 字リブで押さえる。USB-C 側は XIAO ごと通る幅で上から切り欠き、反対側は
    線を落とし込む切り欠き。蓋はネジなしのスナップ。
    - esp32/make_3mf.py: STL を A1 mini のプ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
    [case_tnf2944.3mf, case_tnf2944.scad, case_tnf2944_base.stl, case_tnf2944_lid.stl]
